buteomont/Run-Limiter/extras/compressorLimiter.png

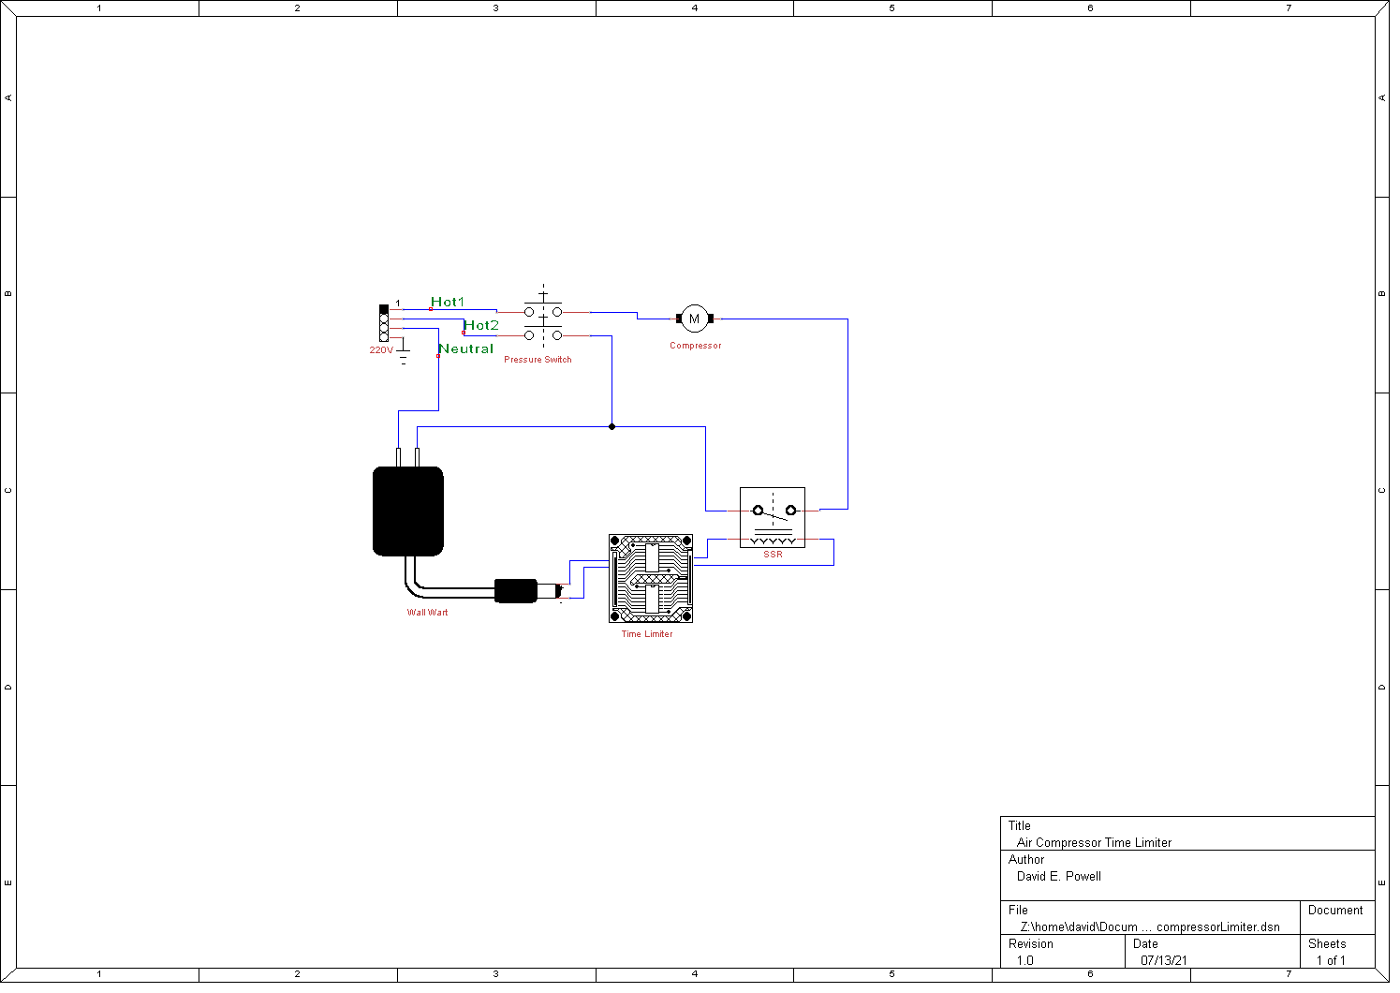
extras/compressorLimiter.png
