buteomont/Run-Limiter/extras/PumpRuntimeLimiter.png

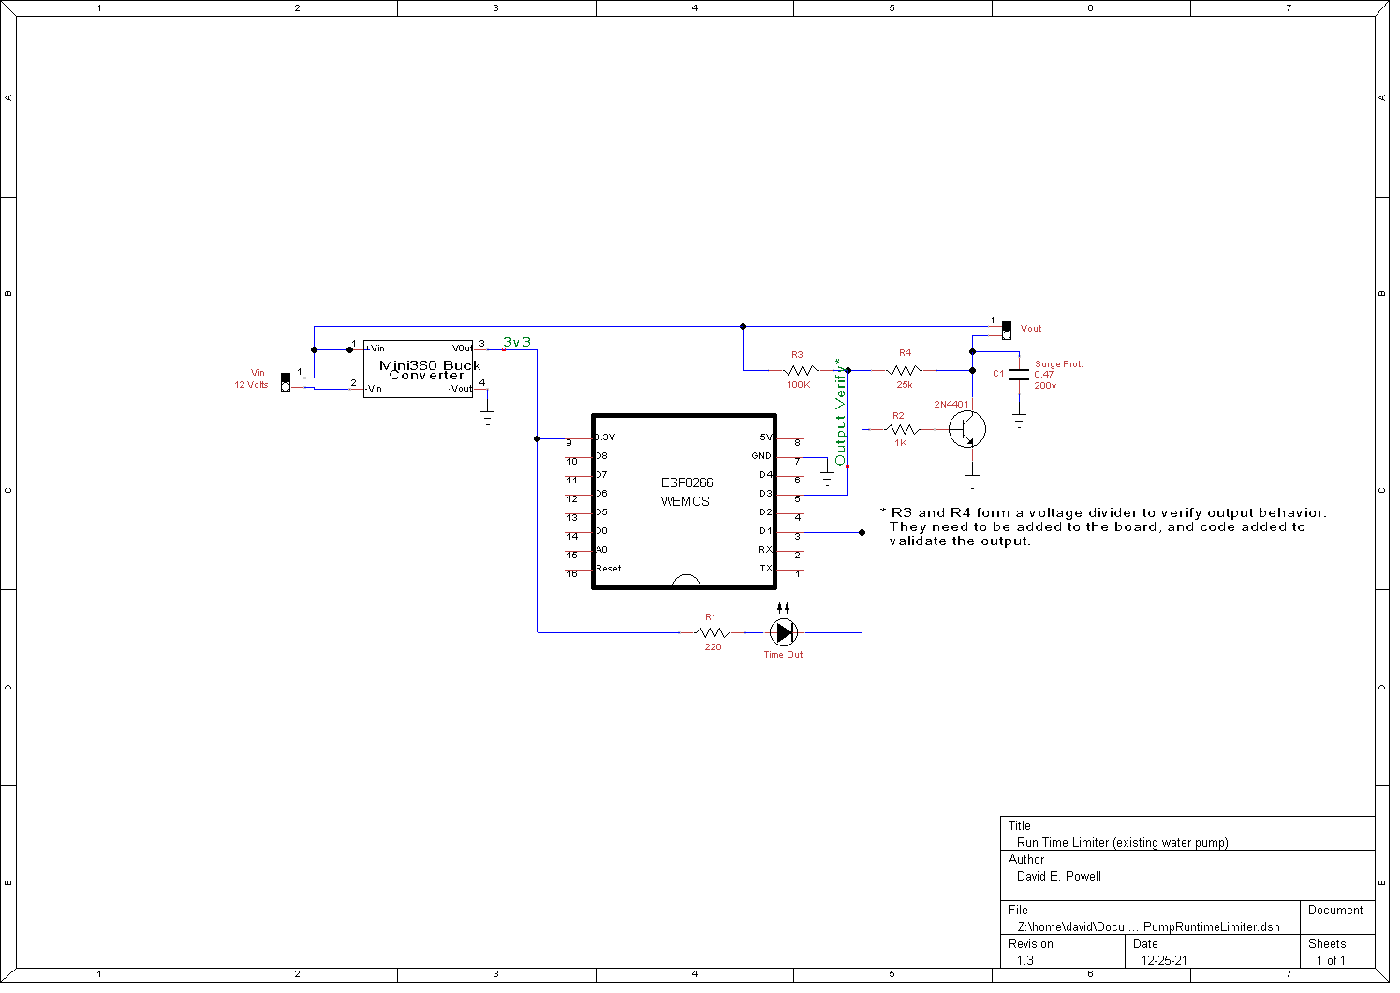
extras/PumpRuntimeLimiter.png
