buteomont/Run-Limiter/extras/RuntimeLimiter.png

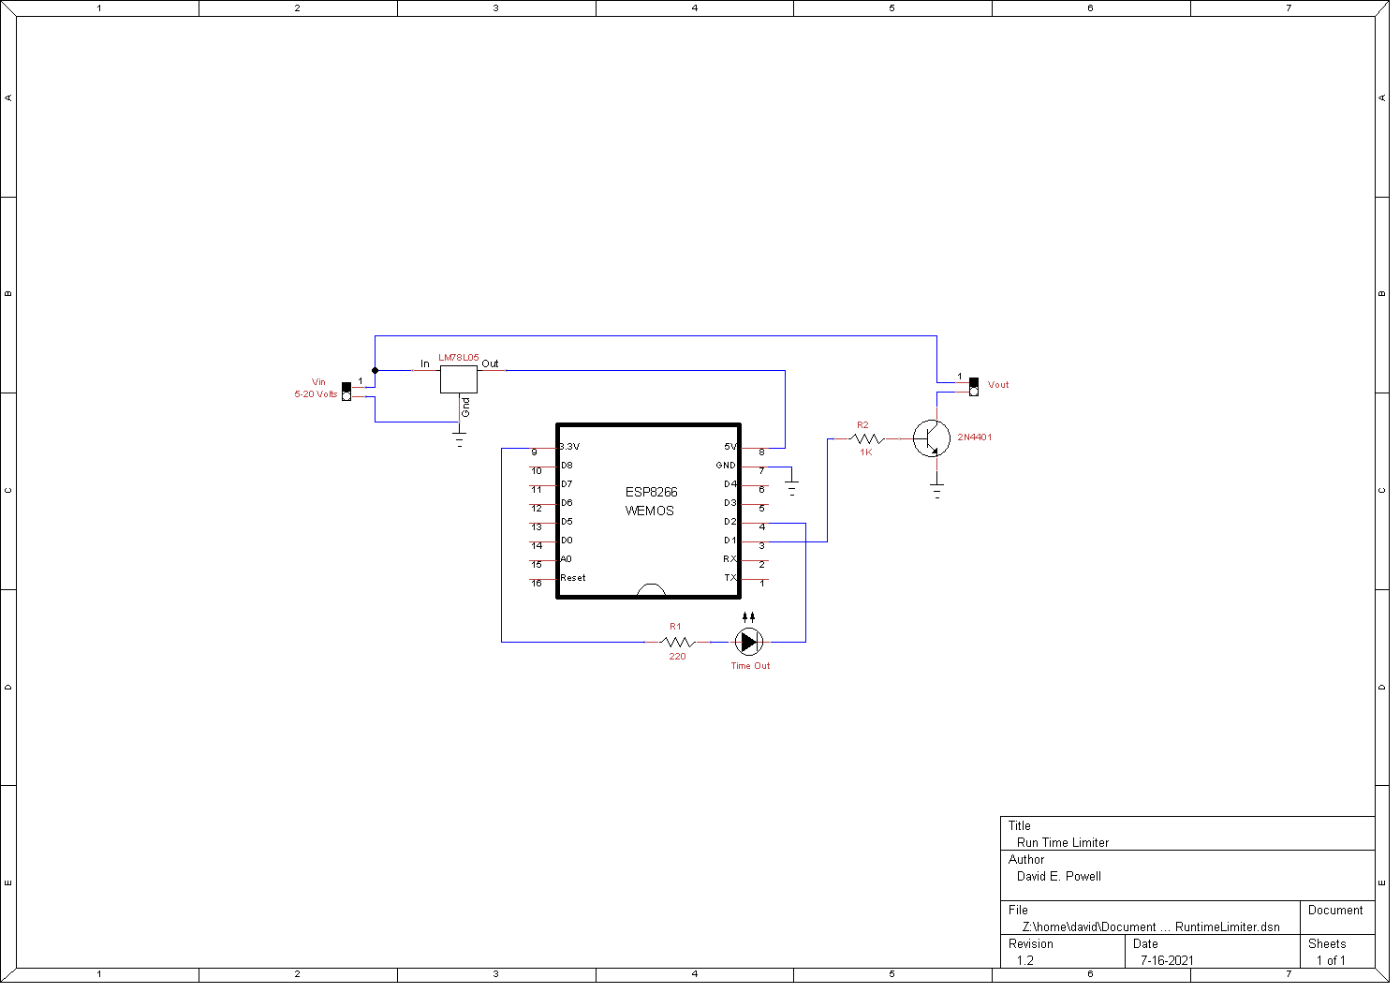
extras/RuntimeLimiter.png
