buteomont/Run-Limiter/extras/runLimiter/Version 3.1/runLimiter BOM.ods

Item | Qty | Reference(s) | Value | LibPart | Rating
1 | 2 | C1, C2 | 1.0 | Device:C_Small
2 | 1 | C3 | 0.1 | Device:C_Small | 1000v
3 | 1 | D1 | LED | Device:LED
4 | 1 | D2 | 1N4003 | Diode:1N4003
5 | 1 | J1 | 5-13 Volts | Connector_TH_Headers:Conn_01x02
6 | 1 | J2 | Vout | Connector_TH_Headers:Conn_01x02
7 | 1 | J3 | Dry Contacts | Connector_Generic:Conn_01x03
8 | 1 | K1 | Relay | Relay:SANYOU_SRD_Form_C
9 | 1 | Q1 | 2N3904 | AZ7029ZTR-E1:2N3904
10 | 1 | Q2 | 2SD2023 | Transistor_BJT:2SC1945
11 | 1 | R1 | 220 | Device:R_Small_US
12 | 1 | R2 | 1K | Device:R_Small_US
13 | 1 | R3 | 12K | Device:R_Small_US
14 | 1 | U1 | MCP1702T-3302E/TO | Regulator_Linear:MCP1700x-330xxTO
15 | 1 | U2 | ESP8266-01s | ESP8266:ESP8266-01s
