buteomont/Run-Limiter/(list of files, drawings)

Other design files:
extras/compressorLimiter.dsn
extras/PumpRuntimeLimiter.dsn
extras/RuntimeLimiter.dsn
