buteomont/Run-Limiter/extras/runLimiter/Version 3.0/runLimiter.kicad_pcb

## KiCad design extras/runLimiter/Version 3.0/runLimiter.kicad_pcb (2023-08-17, an earlier design)

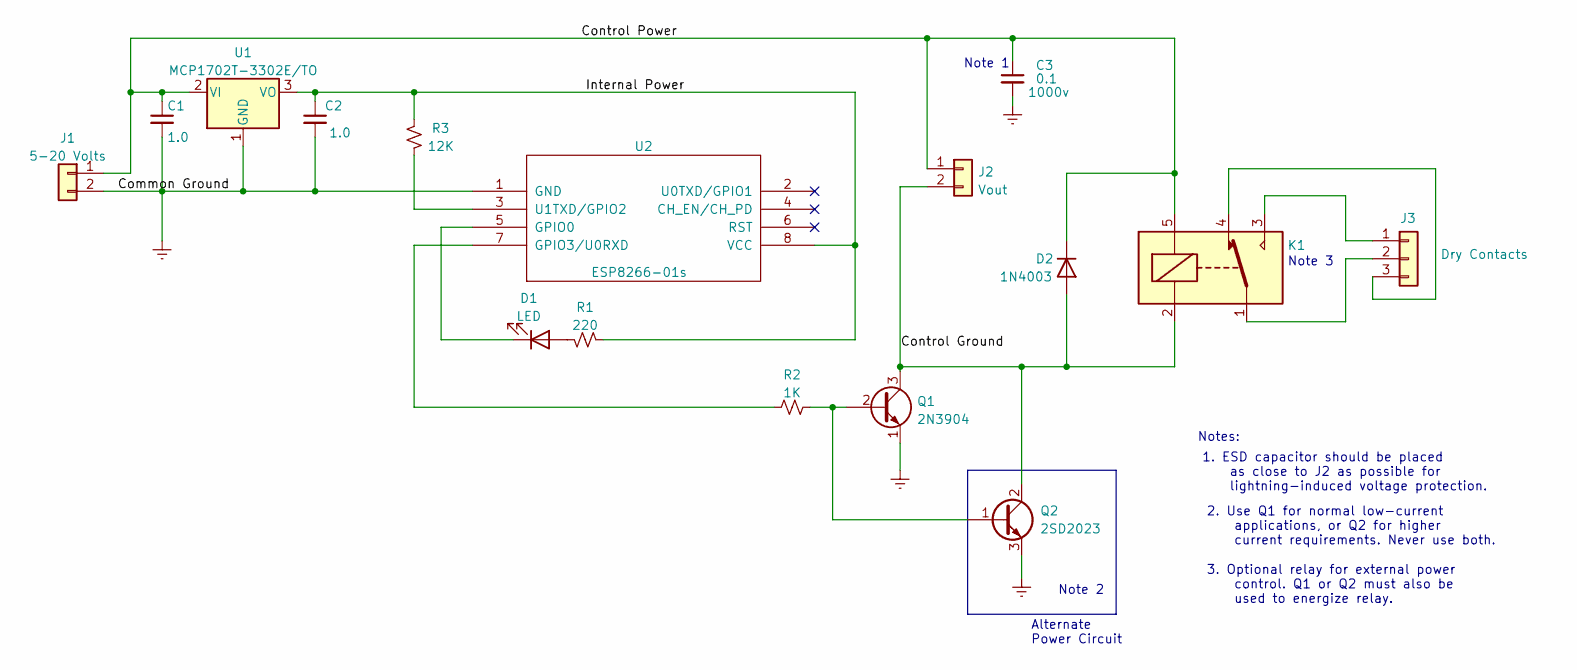
[picture p4: schematic runLimiter.kicad_sch, Run Time Limiter]

Parts:
C1, C2: 1.0; CP_Radial_Tantal_D4.5mm_P2.50mm
C3: 0.1; C_Disc_D10.5mm_W5.0mm_P10.00mm; Rating 1000v
D1: LED; LED_D5.0mm
D2: 1N4003; D_DO-41_SOD81_P10.16mm_Horizontal
J1: 5-20 Volts; PinHeader_1x02_P2.54mm_Vertical
J2: Vout; PinHeader_1x02_P2.54mm_Vertical
J3: Dry Contacts; PinHeader_1x03_P2.54mm_Vertical
K1: Relay; Relay_SPDT_SANYOU_SRD_Series_Form_C
Q1: 2N3904; TO-92_Inline
Q2: 2SD2023; TO-220-3_Vertical
R1: 220; R_Axial_DIN0207_L6.3mm_D2.5mm_P10.16mm_Horizontal
R2: 1K; R_Axial_DIN0207_L6.3mm_D2.5mm_P10.16mm_Horizontal
R3: 12K; R_Axial_DIN0207_L6.3mm_D2.5mm_P10.16mm_Horizontal
U1: MCP1702T-3302E/TO; TO-92_Inline
U2: ESP8266-01s

Connections:
/Control Ground: D2.2 (A), J2.2, K1.2, Q1.3 (C), Q2.2 (C)
/Control Power: C1.1, C3.1, D2.1 (K), J1.1, J2.1, K1.5, U1.2 (VI)
/Internal Power: C2.1, R1.2, R3.2, U1.3 (VO), U2.8 (VCC)
GNDREF: C1.2, C2.2, C3.2, J1.2, Q1.1 (E), Q2.3 (E), U1.1 (GND), U2.1 (GND)
unnamed: D1.1 (K), U2.5 (GPIO0)
unnamed: D1.2 (A), R1.1
unnamed: J3.2, K1.1
unnamed: J3.1, K1.3
unnamed: J3.3, K1.4
unnamed: Q1.2 (B), Q2.1 (B), R2.1
unnamed: R2.2, U2.7 (GPIO3/U0RXD)
unnamed: R3.1, U2.3 (U1TXD/GPIO2)

Notes on the sheet:
Note 3
Notes:
3. Optional relay for external power control. Q1 or Q2 must also be used to energize relay.
1. ESD capacitor should be placed as close to J2 as possible for lightning-induced voltage protection.
Alternate Power Circuit
Note 1
Note 2
2. Use Q1 for normal low-current applications, or Q2 for higher current requirements. Never use both.

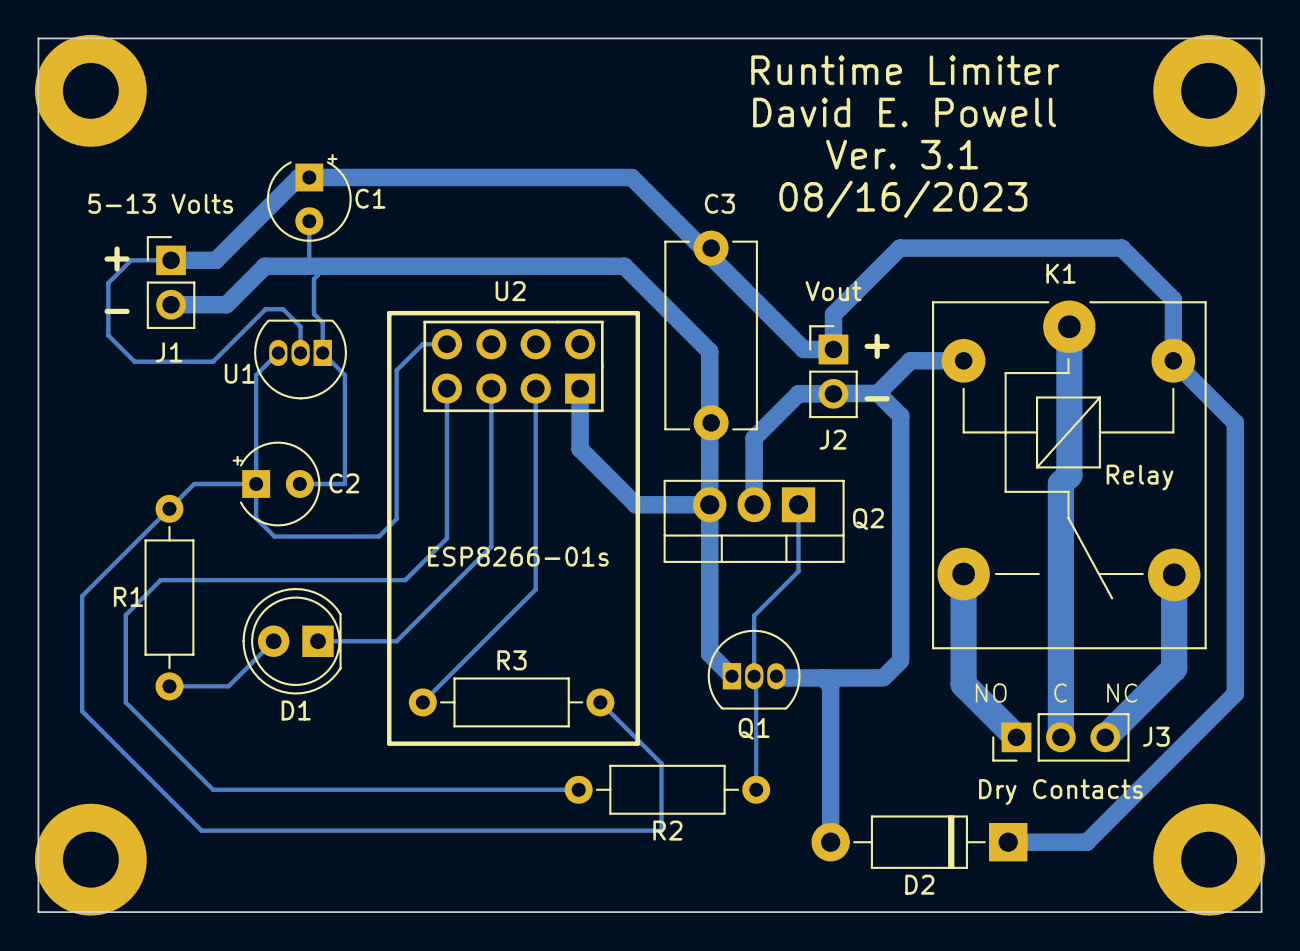
[picture p5: board extras/runLimiter/Version 3.0/runLimiter.kicad_pcb from above]

Board: 2 copper layers, 70.0 x 50.0 mm, 16 parts (0 on the bottom side), 12 nets.
