buteomont/Run-Limiter/extras/runLimiter/Version 1.0/runLimiter.kicad_pcb

## KiCad design extras/runLimiter/Version 1.0/runLimiter.kicad_pcb (2023-08-08, an earlier design)

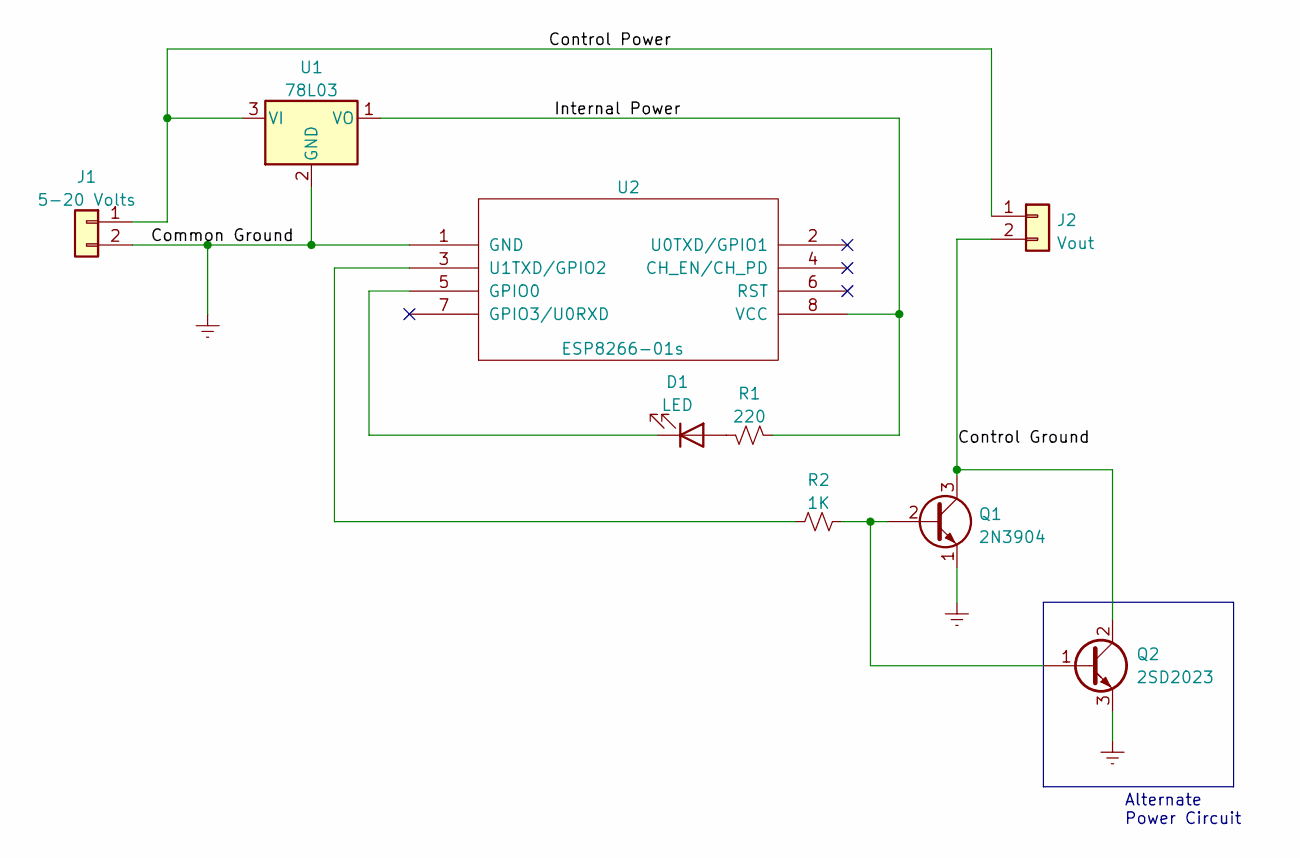
[picture p6: schematic runLimiter.kicad_sch]

Parts:
D1: LED; LED_D5.0mm
J1: 5-20 Volts; PinHeader_1x02_P2.54mm_Vertical
J2: Vout; PinHeader_1x02_P2.54mm_Vertical
Q1: 2N3904; TO-92_Inline
Q2: 2SD2023; TO-220-3_Vertical
R1: 220; R_Axial_DIN0207_L6.3mm_D2.5mm_P10.16mm_Horizontal
R2: 1K; R_Axial_DIN0207_L6.3mm_D2.5mm_P10.16mm_Horizontal
U1: 78L03; TO-92_Inline
U2: ESP8266-01s

Connections:
/Control Ground: J2.2, Q1.3 (C), Q2.2 (C)
/Control Power: J1.1, J2.1, U1.3 (VI)
/Internal Power: R1.2, U1.1 (VO), U2.8 (VCC)
GNDREF: J1.2, Q1.1 (E), Q2.3 (E), U1.2 (GND), U2.1 (GND)
unnamed: D1.1 (K), U2.5 (GPIO0)
unnamed: D1.2 (A), R1.1
unnamed: Q1.2 (B), Q2.1 (B), R2.1
unnamed: R2.2, U2.3 (U1TXD/GPIO2)

Notes on the sheet:
Alternate Power Circuit

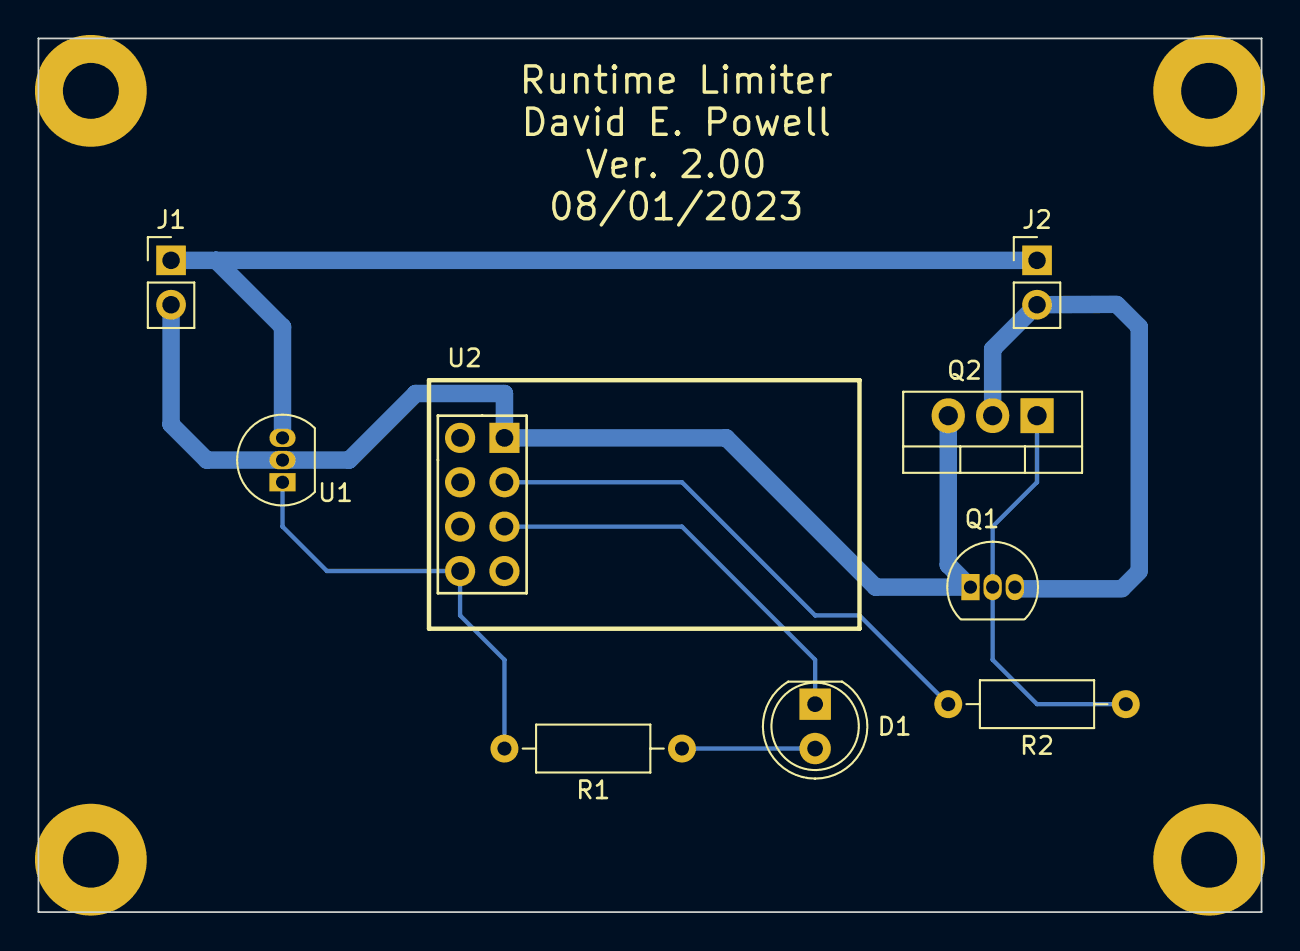
[picture p7: board extras/runLimiter/Version 1.0/runLimiter.kicad_pcb from above]

Board: 2 copper layers, 70.0 x 50.0 mm, 9 parts (0 on the bottom side), 8 nets.
