buteomont/Run-Limiter/(commit log)

2021-07-03 Added schematic
    [RuntimeLimiter.dsn]
2021-07-17 Moved timeout LED to port D2
    [compressorLimiter.dsn]
2021-07-18 Updated schematic
    [RuntimeLimiter.dsn]
2021-12-26 Added schematic and note about water pump
    [PumpRuntimeLimiter.dsn, RuntimeLimiter.dsn]
2022-04-09 Added protection capacitor to output Added feedback divider for output verification
    [PumpRuntimeLimiter.dsn, RuntimeLimiter.dsn]
2023-06-20 Added support to enable and disable flashing LED
    [PumpRuntimeLimiter.dsn]
2023-06-20 Exported images of schematics
2023-06-20 Fixed settings carriage return bug
    [main.cpp, runLimiter.h]
2023-07-10 PC board files
    [runLimiter-B_Cu.gbr, runLimiter-B_Mask.gbr, runLimiter-B_Paste.gbr, runLimiter-B_Silkscreen.gbr, runLimiter-Edge_Cuts.gbr, runLimiter-F_Cu.gbr, runLimiter-F_Mask.gbr, runLimiter-F_Paste.gbr]
2023-08-08 Modified directory structure
    [runLimiter-B_Cu.gbr, runLimiter-B_Mask.gbr, runLimiter-B_Paste.gbr, runLimiter-B_Silkscreen.gbr, runLimiter-Edge_Cuts.gbr, runLimiter-F_Cu.gbr, runLimiter-F_Mask.gbr, runLimiter-F_Paste.gbr]
2023-08-16 Moved power control from GPIO2 to GPIO3
    [runLimiter-B_Cu.gbr, runLimiter-B_Mask.gbr, runLimiter-B_Silkscreen.gbr, runLimiter-Edge_Cuts.gbr, runLimiter-F_Cu.gbr, runLimiter-F_Mask.gbr, runLimiter-F_Silkscreen.gbr, runLimiter-NPTH-drl.gbr]
2023-08-16 Refactored files, replaced C1, C2 footprints
    [runLimiter-B_Cu.gbr, runLimiter-B_Mask.gbr, runLimiter-B_Silkscreen.gbr, runLimiter-Edge_Cuts.gbr, runLimiter-F_Cu.gbr, runLimiter-F_Mask.gbr, runLimiter-F_Silkscreen.gbr, runLimiter-NPTH-drl.gbr]
2023-08-16 Updated version number on silkscreen
    [runLimiter.kicad_pcb]
2023-08-17 Changes to board and schematic
    [runLimiter-B_Cu.gbr, runLimiter-B_Mask.gbr, runLimiter-B_Silkscreen.gbr, runLimiter-Edge_Cuts.gbr, runLimiter-F_Cu.gbr, runLimiter-F_Mask.gbr, runLimiter-F_Silkscreen.gbr, runLimiter-NPTH-drl.gbr]
2023-09-07 Added PRECONFIGURE #define for to enable serial
    [runLimiter BOM.ods, runLimiter.csv, runLimiter.kicad_sch]
2026-05-01 fixed some syntax that was generating warnings
    [main.cpp]
